icebreaker-fpga/icebreaker/(notices)

Notices in the files:
hardware/v1.0e/icebreaker.kicad_pcb:
(C) 2019 Piotr Esden-Tempski
(C) 2019 1BitSquared
License: CC-BY-SA 4.0
1B2 (C) 2019
CC-BY-SA 4.0
(C) 2019
hardware/v1.0e/icebreaker.kicad_sch:
License: CC-BY-SA V4.0
hardware/bitsy-v1.1a/icebreaker-bitsy.kicad_sch:
© 2018-2020 1BitSquared
© 2018-2020 Piotr Esden-Tempski
© 2020 Jordi Pakey-Rodriguez
hardware/bitsy-v1.1c/icebreaker-bitsy.kicad_pcb:
© 2018-2021 1BitSquared
© 2020-2021 Jordi Pakey-Rodriguez
hardware/bitsy-v0.1a/icebreaker-bitsy.kicad_pcb:
(C) 2018 Piotr Esden-Tempski
(C) 2018 1BitSquared
CC-BY-SA
hardware/v1.0b/icebreaker.kicad_pcb:
1B2 (C) 2018
(C) 2018
hardware/bitsy-v0.3a/icebreaker-bitsy.kicad_pcb:
(C) 2018-2020 Piotr Esden-Tempski
(C) 2018-2020 1BitSquared
